ryanym/autonomous-foosball-table/README.md

# autonomous-foosball-table
mini foosball table - two rods per team

# Release Notes
| Version | Date | Release Log |  
|---|---|---|
| 0.0.1 | Feb 18 | Assemebled linear motion system |  
| 0.0.2  | Mar 1 | Recived steps from PC | 
| 0.0.3 | Mar 15 | Mapped steps to rod positios for linear position |  
| 0.1.1 | Mar 17 | Optimized step delay, Follow foosball's y position |
