ryanym/autonomous-foosball-table/Documentation/DevelopmentProcessandImplementationRev0.docx

# Development Process and Implementation

Group 4: Autonomous Foosball Table

Revision 0

October 18, 2015

Members:

Yue(Ryan) Ma | 1147335
Chenhe Li | 1158035
Taha Hussain | 1200349
Viktor Smirnov | 1154392
Zi(Roland) Zhou | 1216063
Alvin Li | 0957972

# 1 REVISIONS

Version | Date | Author | Description
0 | October 19, 2015 | Yue(Ryan) Ma, Chenhe Li, Taha Hussain, Viktor Smirnov, Zi(Roland) Zhou, Alvin Li | Initial version

# 2 TABLE OF CONTENTS

Revisions | 1
Table of Contents | 2
Introduction | 4
Purpose | 4
Scope | 4
References | 4
Development process | 5
Overall development process | 5
Detailed development process | 7
Roles and responsibilities | 10
Tools and standard | 11
Tools | 11
Standard | 11
Version control | 12
Tool | 12
Version controlled item | 12
Software: | 12
Electrical: | 12
Mechanical: | 12
Documentation: | 12
Usage of version control | 13
General | 13
Bug report and tracking | 13
Change request | 13
Bug and change documentation | 13
Issue labeling | 13

# 3 INTRODUCTION

## 3.1 Purpose

The purpose of this Development Process and Implementation document is to define the overall develop process flow and how each step should be implemented. This document will be used as an execution plan for the development autonomous foosball table and help teaching assistants and supervising professor as well as ourselves in tracking our development progress.

## 3.2 Scope

The focus of this document is on the steps that needed to be done during the overall development, including roles and responsibilities of team members, tools and versions of tools will be used and method of version control.

# 4 DEVELOPMENT PROCESS

## 4.1 Overall development process

Development process is based on V-model process. (see Figure 1.1 below)

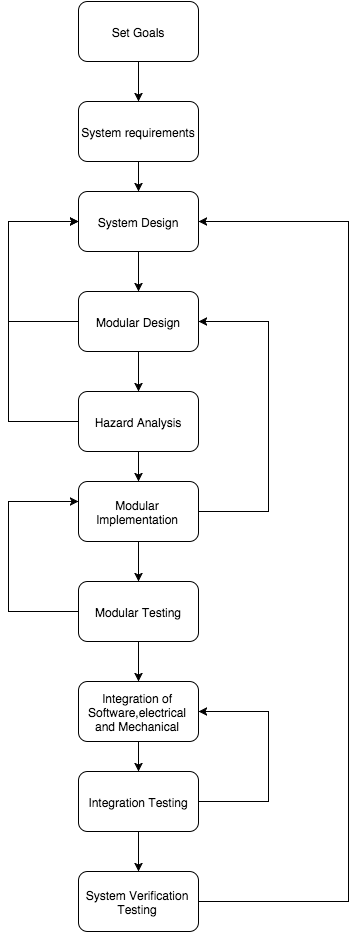
[picture p9: figure]

Figure 1.1

## 4.2 Detailed development process

1. Set projects goals
  a. Input:
    i. List of official rules for foosball
    ii. Statistics of the ability of an average player
    iii. Possible customer research
    iv. existing products
  b. Output:
    i. A list of actions and rules that must be achieved and followed by a robotic foosball table that simulates a human player and provides competitive gameplay
  c. Acceptance Criteria:
    i. Goal are achievable
    ii. Goals should be clear, concise and well defined.
    iii. Goals should have reasonable justification
2. System requirements
  a. Input:
    i. A list of actions and laws that must be achieved by a robotic foosball table that simulates a human player
  b. Output:
    i. Functional requirements: a list of actions required to achieve the goals
    ii. Non-functional requirements: a list of metrics required for effectiveness measurement of the functional requirements
    iii. Controlling and monitoring variables
    iv. Functional Decomposition Diagram
  c. Acceptance Criteria:
    i. Requirements should not contradict each other
    ii. Requirements should be concise and cover all possible actions and reactions of a system
    iii. Requirements should be aimed at fulfilling the goals
    iv. There should be no redefinitions of requirements
3. System design
  a. Input:
    i. functional requirements
    ii. non-functional requirements
    iii. functional decomposition diagrams
  b. Output:
    i. a workflow of interaction between the subsystems required to achieve the functional requirements
    ii. Behaviour description for all the components
  c. Acceptance Criteria:
    i. The system should meet the requirements
    ii. The design should have its input and outputs well defined and the output of the entire system should be in compliance with the goals desired from the system
    iii. Each module should not affect other module’s behaviour in any other way than intended in the design
4. Modular design: software design/mechanical design/electrical design
  a. Input:
    i. A workflow of interaction between the subsystems required to achieve the functional requirements
    ii. Non-functional requirements
    iii. Cost analysis for parts
    iv. Behaviour description of all the components
  b. Output:
    i. Interface specification for each module
    ii. Internal design for each module
    iii. A simulation, prototype or engineering drawing of all subsystems
  c. Acceptance Criteria:
    i. The input and outputs of subsystems are restricted the pairs of input and output to reflect all requirements
    ii. All the routine satisfying the input/output relation is correct and acceptable
    iii. Each module should meet the requirements for this particular module
5. Hazard analysis
  a. Input:
    i. Workflow of all subsystems
    ii. Functional requirements
    iii. Simulation/prototype of all major subsystems
  b. Output:
    i. Flowchart of system functions
    ii. FMEA Chart
  c. Acceptance Criteria:
    i. Should prove that the analysis covers all possible outcomes of the system with all possible inputs
    ii. Clearly defines which standard was used and its justification and how that standard was followed during the analysis
6. Modular implementation: software implementation/mechanical implementation/electrical implementation
  a. Input:
    i. Modular design for each module
    ii. An interface specification for each module
  b. Output:
    i. Working subsystems
  c. Acceptance Criteria:
    i. Each module meets the modular internal design requirement.
    ii. The input and outputs of each module meet the interface specification
7. Modular testing: software testing/electrical testing
  a. Input:
    i. Working subsystems
    ii. System requirement
  b. Output:
    i. Verified subsystems
    ii. Test log
  c. Acceptance Criteria:
    i. All the cases of each module are tested
    ii. The expected output and the output of the testing module are the same for the same testing input
8. Integration of software, electrical and mechanical system.
  a. Input:
    i. Working subsystems
    ii. System requirement
  b. Output:
    i. Integrated system
  c. Acceptance Criteria:
    i. Integrated system meets the requirement
9. Integration testing
  a. Input:
    i. Integrated system
    ii. System requirement
  b. Output:
    i. A working system
    ii. Test log
  c. Acceptance Criteria:
    i. All the cases of each module are tested
    ii. The expected output and the output of the integrated system are the same for the same testing input
10. System verification testing
  a. Input:
    i. A working system
    ii. Requirement
    iii. Project goal
  b. Output:
    i. A list of metrics that state if the requirements are met
    ii. Test log
  c. Acceptance Criteria:
    i. The behaviour of the system match the goals of the project
    ii. The behaviours of the system satisfy the requirements specification.
    iii. The outputs from black-box and white-box tests are the same as the expected values

## 4.3 Roles and responsibilities

This project will be divided into three major component: software, electrical and mechanical. Table 1.1 displays the responsibilities and work distribution within the team. Table 1.2 states the leader for individual component.

| Software | Electrical | Mechanical
Ryan Ma | development/testing
Chenhe Li | development
Taha Hussain | development | development/testing
Viktor Smirnov | | development | development/testing
Roland Zhou | development/testing
Alvin Li | | development/testing | development

Table 1.1 Responsibilities of team members

Software lead | Electrical lead | Mechanical lead | Documentation lead
Chenhe Li | Taha Hussain | Viktor Smirnov | Ryan Ma

Table 1.2 Component leaders

# 5 TOOLS AND STANDARD

## 5.1 Tools

- Software:
  - Language: C++ 11, C
  - IDE: Visual Studio 2015 Community, Keil uVision 4.0.0
  - External library: OpenCV 3.0 for C++
  - CAD tool: AutoCAD 2015
  - Algorithm simulation: Matlab 2014a
  - Circuit design and simulation: Multisim Student Edition
  - PCB layout: KiCad 4.0.0 RC1
- Hardware:
  - Microcontroller: STM32F4 Discovery board

## 5.2 Standard

- Coding standard: Google C++ Coding Standard

# 6 VERSION CONTROL

## 6.1 Tool

A private Github repository will be used as our version control tool. Git and Github are known to be easy to learn and use. Furthermore Git is integrated with most popular IDEs which makes version control more effective.

## 6.2 Version controlled item

### 6.2.1 Software:

- Source code of the user program including config files
- External libraries used in the project
- User program(binary file)

### 6.2.2 Electrical:

- Circuit designs:
  - Transfer functions
  - Schematic
  - Truth tables
  - Electronic components and ratings
  - CAD designs
- Circuit simulations of circuit designs

### 6.2.3 Mechanical:

- Hardware dimensions (length, mass, diameter, and etc.)
- CAD modeling

### 6.2.4 Documentation:

- Development process & implementation
- Project goals
- Requirement
- System design
- Hazard Analysis
- Implementation
- V & V

## 6.3 Usage of version control

### 6.3.1 General

For software, one member will create an empty base project and the others will synchronize this base project to local. Ideally each member should work on different modules at the same time to reduce the number of conflicts when pushing the files to the repository. When committing sources files, the team member shall state the changes in the file and reasons for the changes in the commit comment. In software component team members need to make sure the committed changes will not break the current build. Also members shall always pull from the repository to get the updated version of the project before modifying any source file.

### 6.3.2 Bug report and tracking

A bug report will be opened using Github’s “issue” feature when a bug is found by the tester with label “bug”. In the Github issue, the tester shall keep a record of the test case failed and logs about the failure. Then the component leader shall assign the bug to appropriate member to fix. Once the bug is fixed, tester must validate the fix first before closing the issue.

### 6.3.3 Change request

Similar to bug report, change request shall also be opened by Github’s “issue” feature. If a team member decides to make a change from the design level, a change request must be opened in the issue with label “changerequest”. Component leaders shall then review the request and make the decision. If the request is approved, component leader then assigns the request to appropriate team member.

### 6.3.4 Bug and change documentation

Bugs and changes shall be documented by Github’s “issue” feature. Proper description must be added in the comment when opening and closing the issue.

### 6.3.5 Issue labeling

The following labels must be including when opening a new issue. The labels can classify issues thus significantly increases project management proficiency.

- bug: issue is a bug report
- changerequest: issue is a change request
- enhancement: issue is about enhancement
