ryanym/autonomous-foosball-table/Motor/convert_steps_angular.ino

//takes in real angle in degrees and current step postion and converts to number of steps
int angle_to_steps(float angle,int motor_current){
 //200 steps per rotation
 float steps = (angle * rotational_steps) / (float)(360.0) - motor_current;
 return((int)steps);
  }
