ryanym/autonomous-foosball-table/computer vision/arduino.py

import serial
import time



# return a string sperated by commas with an endline character 'n' for sending over serial comm
# ex [3,4,5,6,3] = "3,4,5,6,3,n"
# there has to be a comma at the end to signify ending of characters
def array_to_string(x):
    str_send = ""
    for j in range(0, len(x)):
        str_send = str_send + str(x[j]) + ","
    str_send += "n"
    return (str_send)


# 825,800,1000,0.3 for linear
# 1000,950,1000,0.3 for rotaioanal
# after motor delay has to be atleast a value so it wont add erros. 500 works but adds erros.atleast 800 needed.
motor_delay = 1000;
after_delay = 1000;
polarity_delay = 1000;

# 0,0,0,0,'t',950,600,1000,

# @parma = [int row1_linear,int row1_roational,int row2_linear,int row2_roational,character t or f)
# ex [1,2,3,4,t]
def SendController(x):
    COM_Port = 8;
    # turning on serial
    # serARD = serial.Serial(port='/dev/cu.usbmodem1411', baudrate=9600);
    serARD = serial.Serial(port='COM18',baudrate=9600)
    # printing the serial port conencted to
    # print serARD.name
    print (x[0])
    data = 0;
    i = 0;
    j = 0;

    # converting arrray into a sendable string
    str_send = array_to_string(x)

    # writing the string to the serial port
    serARD.write(str_send);

    # readinf data and printing it
    # data = serARD.read(len(str(data_write))+1);
    # print data

    # important to close
    serARD.close()

time_sleep = 0.15;
# p2 = [200,1100,200,200,'t']
# n2 = [-200,1100,200,200,'t']
#l1 = [0, .9, 0, 0, 't', motor_delay, after_delay, polarity_delay]
l1 = [95, 360, 95, 360]
l2 = [0, 0, 0, 0]
r1 = [10, 360, 0, 0]
r2 = [40, 0, 4, 0]

home = [0, 0, 0, 0]
def test():
    for i in range(5):
        SendController(l1)
        time.sleep(time_sleep)
        SendController(l2)
        time.sleep(time_sleep)
    SendController(home);

#R2(home);
#test();

# notes on implementation
# send a byte to start the signal
# TESTS
# see how many bytes neede for expect4ed values of characters
# PROBELMS
# arduino resets on serial comm which can be resolved by using a capactor between RESET and 5V
