ryanym/autonomous-foosball-table/(commit log)

2015-12-07 foosman filter
2016-02-04 motor test
2016-02-05 change pin to cnc
2016-02-05 motor_comm
    motor communicaiton intial
    arduino and python scripts
2016-02-06 Added Move_motor
    Main function is Move_Motor(), made some changes to the main file and
    added some pin definitions for the ramps controller. Move_motor and the
    newer files are still unteseted. Comm part does not seem to work
    correctly with alot of shit running.
    [convert_steps_angular.ino, convert_steps_linear.ino, pin_def.h, setup.ino]
2016-02-06 changes
    tested linear to steps , rotaitonal to steps , and move motor sub
    funcitons. Move motor remains untested.
2016-03-05 Motor controller code
    Motor controller code fully working except homing phase. Delays still
    need to be changed.
2016-03-05 Motor delay testing
    Added functionaloty for changign motor delays form python.
2016-03-06 linear motor homing support
    Motor linear homing working. Rotational not yet implemented.
2016-03-09 Q motor port functionality
    Port Z burn out (LOL). Had to initialize Q port and change the pin
    mappings for motors.
    [arduino.py, setup.ino]
2016-03-11 Additional check for serial---UNTESTED
    Check after step for the particular motor
2016-03-12 Make mid serial working
    Cant use Serial.print() right after serial.avaibale() .
    Timing for communication fonud to be atleast 6ms.
2016-03-14 safety stuff
    - safety interrupt on pin 2 working
    - safety for pc flag
2016-03-14 Eye driver
2016-03-21 added one more delay
    added delay for motor after each motor ON. So there is a delay between
    all the four motors turning on.
2016-03-21 delay changes to 2000
    after motor delay = 0
    changed \n charcter in arudino for com
2016-03-22 safety feature in comm
    added the feature that recognizes t or f flag for safety and swithces
    motors off accordingly
2016-03-24 Made serparte AI file AND activated swithces in arduino
2016-03-27 Arduino to PC, Serial ifdefs
    1ms delay in arduino
    60 ish ms delay in PC
    Serial ifdef to switch them off when needed
2016-03-27 minor changes to previous,
    NOTE : Fucntion get current steps assumes thatserial port is open and
    does not close it.
2016-03-27 get current steps converted values returned
2016-03-28 demo candidate 2, added 2 switches, improved accuracy
2016-03-28 added fan pin
2016-03-31 added Reset functionality
    -send 'R' for Reset from computer
    [Motor.ino, ReadSteps.ino, setup.ino]
2016-04-25 Revert to candidate 4
    This reverts commit 78ef12295159b0dba7be31b6543fb62244b29ba7.
    [AI.py, Communication.py, Homing.ino, ImageProcessing.py, Main.py, Motor.ino, MoveMotor.ino, ReadSteps.ino]
2016-04-26 configured all sensor pins
2016-04-26 Sensor pins FINALLY DONE
2016-04-26 fixed kickback for rod0, rod1
    [Rod.py]
2016-04-26 added h for homing flag
2016-04-26 motor homing flag
